s-grundner/STM32-DevBoard/README.md

# STM32 Devboard

With onboard Temp/Humidity Sensor and IMU

Primary goal is to use components I have stock

## Repository Structure

### [Documentation](/documentation/)

### [Manufacturing](/manufacturing/)

### [Simulations](/simulations/)

### [Source Code](/source/)
