s-grundner/STM32-DevBoard/manufacturing/STM32_DevBoard/STM32_DevBoard.kicad_pcb

## KiCad design manufacturing/STM32_DevBoard/STM32_DevBoard.kicad_pcb (2023-08-23)

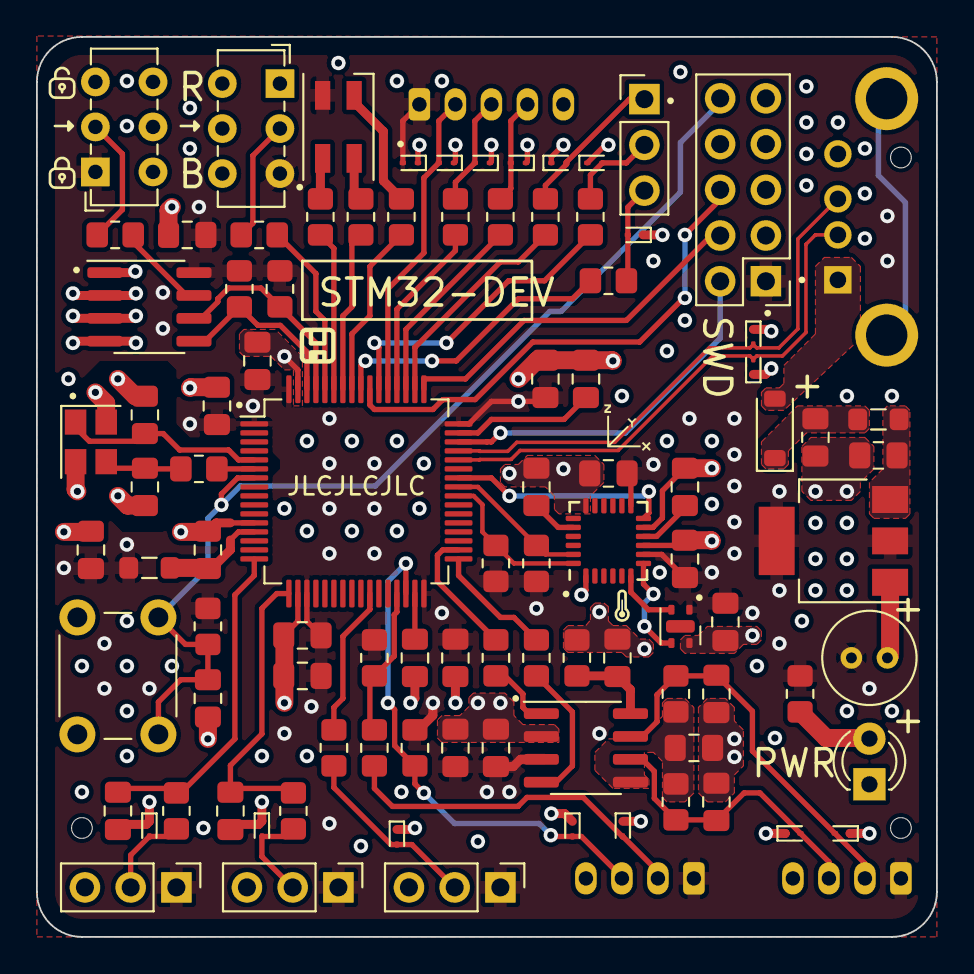
[picture p1: board STM32_DevBoard.kicad_pcb from above]

Board: 4 copper layers, 50.0 x 50.0 mm, 101 parts (0 on the bottom side), 65 nets.

Parts:
C1, C2, C3, C4, C5, C7, C15, C17, C18, C20, C27, C28, C29, C30, C31: 100n; C_0805_2012Metric_Pad1.18x1.45mm_HandSolder
C6: 4u7; C_0805_2012Metric_Pad1.18x1.45mm_HandSolder
C8, C9, C10, C22, C26, C33: 2u2; C_0805_2012Metric_Pad1.18x1.45mm_HandSolder
C11, C12: 12p; C_0805_2012Metric_Pad1.18x1.45mm_HandSolder
C13: 820n; C_0805_2012Metric_Pad1.18x1.45mm_HandSolder
C14: 22u; C_Radial_D5.0mm_H7.0mm_P2.00mm
C16: 2n2; C_0805_2012Metric_Pad1.18x1.45mm_HandSolder
C19: 10n; C_0805_2012Metric_Pad1.18x1.45mm_HandSolder
C23, C25: 560n; C_0805_2012Metric_Pad1.18x1.45mm_HandSolder
D1: LED_RGBA; LED_SK6812MINI_PLCC4_3.5x3.5mm_P1.75mm
D2: GN; LED_D3.0mm
D3, D4, D5, D6, D7, D8, D9, D10, D11, D12, D13, D15, D17, D18, D20, D22: 3V3; D_SOD-923
D24: B5819W; D_SOD-123
FB1, FB2: 100R @ 100MHz; L_0805_2012Metric_Pad1.05x1.20mm_HandSolder
H4, H4#2, H4#3: JLC_Tooling
J1: CAN; Molex_Micro-Latch_53254-0470_1x04_P2.00mm_Horizontal
J3, J12: AGPIO; PinHeader_1x03_P2.54mm_Vertical
J5: USB_A; USB_A_CONNFLY_DS1095-WNR0
J6: SWD; PinHeader_2x05_P2.54mm_Vertical
J8: SPI/UART; Molex_Micro-Latch_53254-0570_1x05_P2.00mm_Horizontal
J9: SPI_NSS/GPIO; PinHeader_1x03_P2.54mm_Vertical
J10: I2C; Molex_Micro-Latch_53254-0470_1x04_P2.00mm_Horizontal
J11: PWM0; PinHeader_1x03_P2.54mm_Vertical
R1: 0R; R_0805_2012Metric_Pad1.20x1.40mm_HandSolder
R2, R3, R8: 10k; R_0805_2012Metric_Pad1.20x1.40mm_HandSolder
R4, R5, R6, R11, R23, R24, R25, R26, R27, R28: 1k5; R_0805_2012Metric_Pad1.20x1.40mm_HandSolder
R7, R17, R18, R19, R20, R21, R22: 10R; R_0805_2012Metric_Pad1.20x1.40mm_HandSolder
R9, R14: 47R; R_0805_2012Metric_Pad1.20x1.40mm_HandSolder
R10, R12: 150R; R_0805_2012Metric_Pad1.20x1.40mm_HandSolder
R13, R15: 56R; R_0805_2012Metric_Pad1.20x1.40mm_HandSolder
R16: 5k6; R_0805_2012Metric_Pad1.20x1.40mm_HandSolder
SW1: SW_SPDT; SW_E-Switch_EG1271_SPDT
SW2: SW_Omron_B3FS; SW_PUSH_6mm
SW3: EEPROM_WP; SW_E-Switch_EG1271_SPDT
U1: MPU-6050; InvenSense_QFN-24_4x4mm_P0.5mm
U2: SHTC3; Sensirion_DFN-4-1EP_2x2mm_P1mm_EP0.7x1.6mm
U3: STM32F405RGT6; LQFP-64_10x10mm_P0.5mm
U4: AT24C256; SOIC-8_3.9x4.9mm_P1.27mm
U6: SN65HVD230; SOIC-8_3.9x4.9mm_P1.27mm
U8: AMS1117-3.3; SOT-223-3_TabPin2
Y1: 25MHz 12pF; Crystal_SMD_3225-4Pin_3.2x2.5mm

Connections:
+3V3: C1.1, C2.1, C3.1, C4.1, C5.1, C6.1, C8.1, C14.1, C17.1, C18.1, C19.1, C20.1, C26.1, C27.1, D1.4 (A), D3.2 (A2), FB1.2, J1.1, J3.1, J6.1, J8.1, J10.1, J11.1, J12.1, R3.1, R11.2, R23.1, R24.1, R25.1, R26.1, R27.1, R28.1, SW1.3 (C), SW3.1 (A), U1.8 (VLOGIC), U1.13 (VDD), U2.1 (VDD), U3.1 (VBAT), U3.19 (VDD), U3.32 (VDD), U3.48 (VDD), U3.64 (VDD), U4.8 (VCC), U6.3 (VCC), U8.2 (VO)
+3V3A: C7.1, FB1.1, U3.13 (VDDA)
+5V: D24.2 (A), J5.1 (VBUS)
/Connectors/A_GPIO_2: C25.1, R12.1, U3.16 (PA2)
/Connectors/A_GPIO_3: C23.1, R10.1, U3.17 (PA3)
/Connectors/CAN+: C28.1, D20.2 (A2), J1.2, R13.2, U6.7 (CANH)
/Connectors/CAN-: C30.2, D15.2 (A2), J1.3, R15.1, U6.6 (CANL)
/Connectors/CAN_RS: C31.1, R16.2, U6.8 (Rs)
/Connectors/CAN_RX: R14.1, U3.33 (PB12)
/Connectors/CAN_TX: R9.1, U3.34 (PB13)
/Connectors/I2C_SCL: R22.1, R27.2, U3.29 (PB10)
/Connectors/I2C_SDA: D17.2 (A2), J10.3, R28.2, U3.30 (PB11)
/Connectors/PWM0: R17.1, U3.26 (PB0)
/Connectors/SPI_MISO_RX: R21.1, U3.52 (PC11)
/Connectors/SPI_MOSI: D4.2 (A2), J8.2, U3.53 (PC12)
/Connectors/SPI_NSS0: R18.1, U3.50 (PA15)
/Connectors/SPI_NSS1: R19.1, U3.54 (PD2)
/Connectors/SPI_NSS2: R20.1, U3.56 (PB4)
/Connectors/SPI_SCK_TX: R7.1, U3.51 (PC10)
/Connectors/USB_D+: D5.2 (A2), J5.3 (D+), U3.45 (PA12)
/Connectors/USB_D-: D6.2 (A2), J5.2 (D-), U3.44 (PA11)
/Connectors/VREF: C29.1, R13.1, R15.2, U6.5 (Vref)
/MCU/EEPROM_SCL: R24.2, U3.61 (PB8), U4.6 (SCL)
/MCU/EEPROM_SDA: R23.2, U3.62 (PB9), U4.5 (SDA)
/MCU/EEPROM_WP: R8.2, U4.7 (WP)
/MCU/EEPROM_WP_SW: R8.1, SW3.2 (B)
/MCU/IMU_INT: U1.12 (INT), U3.42 (PA9)
/MCU/NPWM_B: R6.1, U3.57 (PB5)
/MCU/NPWM_G: R5.1, U3.58 (PB6)
/MCU/NPWM_R: R4.1, U3.59 (PB7)
/MCU/NRST: C13.1, J6.10, R3.2, SW2.2, U3.7 (NRST)
/MCU/SENSE_SCL: R25.2, U1.23 (SCL), U3.41 (PA8)
/MCU/SENSE_SDA: R26.2, U1.24 (SDA), U3.40 (PC9)
/MCU/SWCLK: J6.4, U3.49 (PA14)
/MCU/SWDIO: J6.2, U3.46 (PA13)
/MCU/SWO: J6.6, U3.55 (PB3)
/MCU/Strapping/BOOT0: R2.2, U3.60 (BOOT0)
/MCU/Strapping/HSE_IN: C11.1, U3.5 (PH0), Y1.1
/MCU/Strapping/HSE_OUT: R1.2, U3.6 (PH1)
/MCU/Strapping/XTAL_IN: C12.1, R1.1, Y1.3
/PMU/LDO_IN: C33.1, FB2.1, U8.3 (VI)
/PMU/POST_POL: C22.1, D24.1 (K), FB2.2
/Sensors/AUX_SCL: U1.6 (AUX_DA), U2.2 (SCL)
/Sensors/AUX_SDA: U1.7 (AUX_CL), U2.3 (SDA)
GND: C1.2, C2.2, C3.2, C4.2, C5.2, C6.2, C7.2, C8.2, C9.2, C10.2, C11.2, C12.2, C13.2, C14.2, C15.2, C16.2, C17.2, C18.2, C19.2, C20.2, C22.2, C23.2, C25.2, C26.2, C27.2, C28.2, C29.2, C30.1, C31.2, C33.2, D2.1 (K), D3.1 (A1), D4.1 (A1), D5.1 (A1), D6.1 (A1), D7.1 (A1), D8.1 (A1), D9.1 (A1), D10.1 (A1), D11.1 (A1), D12.1 (A1), D13.1 (A1), D15.1 (A1), D17.1 (A1), D18.1 (A1), D20.1 (A1), D22.1 (A1), J1.4, J3.3, J5.4 (GND), J6.3, J6.5, J6.9, J8.5, J10.4, J11.3, J12.3, R16.1, SW1.1 (A), SW2.1, SW3.3 (C), U1.1 (CLKIN), U1.9 (AD0), U1.11 (FSYNC), U1.18 (GND), U2.4 (VSS), U3.12 (VSSA), U3.18 (VSS), U3.63 (VSS), U4.1 (A0), U4.2 (A1), U4.3 (A2), U4.4 (GND), U6.2 (GND), U8.1 (GND), Y1.2, Y1.4
unnamed: D1.3 (BK), R6.2
unnamed: D1.2 (GK), R5.2
unnamed: D1.1 (RK), R4.2
unnamed: D2.2 (A), R11.1
unnamed: D7.2 (A2), J3.2, R10.2
unnamed: D8.2 (A2), J8.3, R21.2
unnamed: D9.2 (A2), J8.4, R7.2
unnamed: D10.2 (A2), J9.3, R20.2
unnamed: D11.2 (A2), J9.2, R19.2
unnamed: D12.2 (A2), J9.1, R18.2
unnamed: D13.2 (A2), J11.2, R17.2
unnamed: D18.2 (A2), J10.2, R22.2
unnamed: D22.2 (A2), J12.2, R12.2
unnamed: R2.1, SW1.2 (B)
unnamed: C16.1, U1.20 (CPOUT)
unnamed: C15.1, U1.10 (REGOUT)
unnamed: C10.1, U3.31 (VCAP_1)
unnamed: C9.1, U3.47 (VCAP_2)
unnamed: R9.2, U6.1 (D)
unnamed: R14.2, U6.4 (R)
