s-grundner/STM32-DevBoard/manufacturing/README.md

# PCB

|Top|Bottom|
|-|-|
||
|
