s-grundner/STM32-DevBoard/source/STM32-DevBoard/Core/Inc/main.h

#define SPI3_NSS0_Pin GPIO_PIN_15
#define SPI3_NSS0_GPIO_Port GPIOA
#define SPI3_NSS1_Pin GPIO_PIN_2
#define SPI3_NSS1_GPIO_Port GPIOD
#define SPI3_NSS2_Pin GPIO_PIN_4
#define SPI3_NSS2_GPIO_Port GPIOB
