s-grundner/STM32-DevBoard/(commit log)

2023-08-20 create Kicad project
    [BSB.kicad_sch, CONN.kicad_sch, MCU.kicad_sch, MCU_Strapping.kicad_sch, PMU.kicad_sch, RevHist.kicad_sch, STM32_DevBoard.kicad_pcb, STM32_DevBoard.kicad_sch]
2023-08-20 upd Schematic
    [CONN.kicad_sch, MCU.kicad_sch, MCU_Strapping.kicad_sch, PMU.kicad_sch, RevHist.kicad_sch, STM32_DevBoard.kicad_sch, Sensors.kicad_sch]
2023-08-20 Revision 1 Prototype
    [STM32_DevBoard.kicad_pcb]
2023-08-20 pinout and Low Level Drivers
2023-08-23 update Board Revision 0
    [CONN.kicad_sch, MCU.kicad_sch, MCU_Strapping.kicad_sch, PMU.kicad_sch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]
