s-grundner/STM32-DevBoard/(notices)

Notices in the files:
source/STM32-DevBoard/Core/Inc/main.h:
Copyright (c) 2023 STMicroelectronics.
All rights reserved.
This software is licensed under terms that can be found in the LICENSE file
